NicolajHave/Selected-Frame-Floor-Planner/src/render/three/README.md

# `src/render/three/` — 3D adapter

3D view over the same `Project` slice the SVG canvas consumes
(`src/store/plannerStore.ts`). It introduces no domain fields of its own and
edits only through store actions, so undo, autosave and the parts list
behave the same in both views.

## Interaction

- Click an object to select it; drag to move it along the floor
  (`scene/useFloorDrag.ts`). Orbiting pauses during the drag, and the
  whole drag is one undo step (`beginGesture` / `endGesture`).
- Wall-mounted catalog items snap to the nearest wall while dragged
  (hold Alt to move freely), same as in 2D.
- With a placement tool armed, clicking the floor places the item.
- Room drawing stays in the 2D plan.

## Coordinate mapping

World coordinates are mm with y pointing "south" on the plan. The scene
is metres, Y-up:

- `(x, y) mm` → `(x·0.001, 0, y·0.001)` (see `MM` in `ThreeCanvas.tsx`)
- 2D rotation θ (clockwise on screen) → `rotation.y = -θ`
- Model origin: centre in X/Z, floor at Y = 0

## Mapping

| Domain | Three.js |
|---|---|
| `RoomPolygon.corners` | `Shape` → `ExtrudeGeometry` floor slab (`Floor.tsx`)  |
| Wall segments | `BoxGeometry(length, wallHeight, wallThickness)` |
| `Pillar.size` + position | `BoxGeometry(width, height, depth)` mesh |
| `InventoryItem.assetRef` | GLB via `assetCatalog.glbUrl` (`InventoryMeshes.tsx`) |
| No `assetRef` / loading | `BoxGeometry` in the item's stored size |
| Wall-hung items (logos) | Lifted to the catalog's `mountHeight` |
| Camera | `OrbitControls` (`controls/OrbitView.tsx`) |

## Assets

Catalog models under `public/assets/3d/*.glb` are generated by
`scripts/generate-assets.mjs` — parametric approximations built from the
SIS catalog dimensions. Regenerate with `node scripts/generate-assets.mjs`.
To upgrade any item to real CAD, export glTF/GLB from SolidWorks and
replace the file; the loader doesn't care where the GLB came from.
The three `.step` files alongside are the original CAD sources we have
so far (see `stepUrl` in `src/lib/assetCatalog.ts`).

## Files

```
three/
├── ThreeCanvas.tsx          # <Canvas/>, camera framing, MM constant
├── scene/
│   ├── Floor.tsx            # room polygon slab
│   ├── Walls.tsx            # box per wall segment
│   ├── Pillars.tsx
│   ├── InventoryMeshes.tsx  # GLB loader + placeholder boxes
│   ├── SelectionBox.tsx     # outline around the selected object
│   ├── useFloorDrag.ts      # select + drag along the floor plane
│   └── Lights.tsx
└── controls/
    └── OrbitView.tsx        # OrbitControls wrapper (no drei)
```
