NicolajHave/Selected-Frame-Floor-Planner/public/assets/thumbs/105-06-011-22-C.png

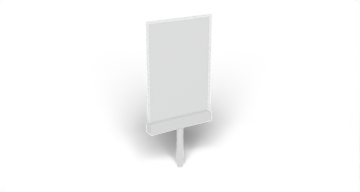
public/assets/thumbs/105-06-011-22-C.png
