NicolajHave/Selected-Frame-Floor-Planner/public/assets/thumbs/105-06-011.png

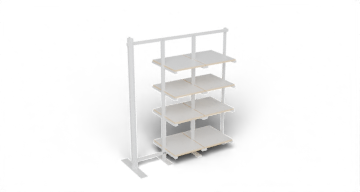
public/assets/thumbs/105-06-011.png
