NicolajHave/Selected-Frame-Floor-Planner/public/assets/thumbs/105-06-014.png

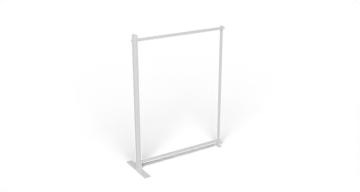
public/assets/thumbs/105-06-014.png
