NicolajHave/Selected-Frame-Floor-Planner/public/assets/thumbs/105-09-001.png

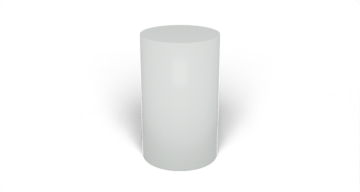
public/assets/thumbs/105-09-001.png
