NicolajHave/Selected-Frame-Floor-Planner/public/assets/thumbs/105-09-003.png

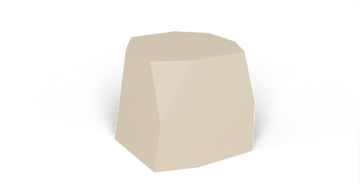
public/assets/thumbs/105-09-003.png
