NicolajHave/Selected-Frame-Floor-Planner/public/assets/thumbs/105-13-015.png

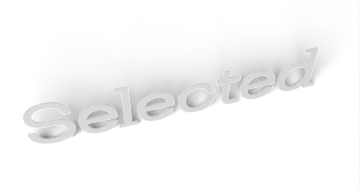
public/assets/thumbs/105-13-015.png
