NicolajHave/Selected-Frame-Floor-Planner/public/assets/thumbs/105-15-004.png

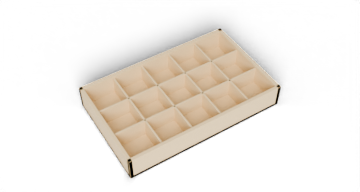
public/assets/thumbs/105-15-004.png
