NicolajHave/Selected-Frame-Floor-Planner/public/assets/thumbs/105-17-007.png

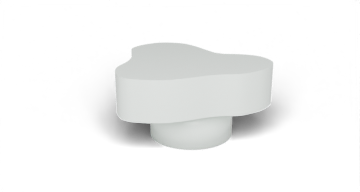
public/assets/thumbs/105-17-007.png
