NicolajHave/Selected-Frame-Floor-Planner/public/assets/thumbs/105-19-001.png

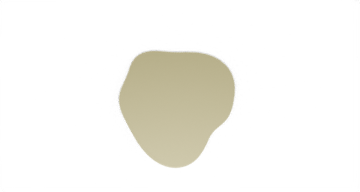
public/assets/thumbs/105-19-001.png
