NicolajHave/Selected-Frame-Floor-Planner/public/assets/thumbs/105-99-003.png

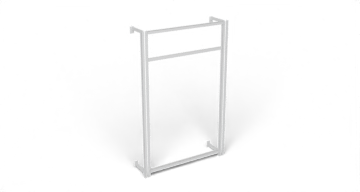
public/assets/thumbs/105-99-003.png
