NicolajHave/Selected-Frame-Floor-Planner/public/assets/thumbs/105-99-005.png

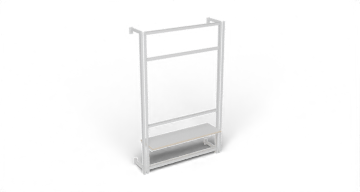
public/assets/thumbs/105-99-005.png
