NicolajHave/Selected-Frame-Floor-Planner/public/assets/thumbs/105-99-009.png

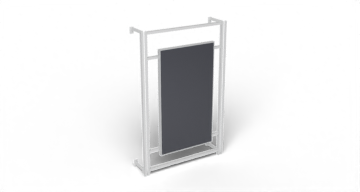
public/assets/thumbs/105-99-009.png
