NicolajHave/Selected-Frame-Floor-Planner/public/assets/thumbs/112-18-001.png

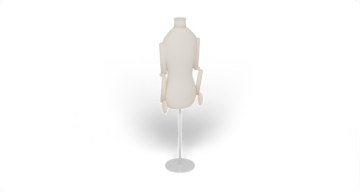
public/assets/thumbs/112-18-001.png
