NicolajHave/Selected-Frame-Floor-Planner/(commit log)

2026-05-08 Add STEP asset library so inventory can carry 3D refs
    Three STEP files (105-06-001-E, 105-09-002-A, 105-17-007-01-A) are
    shipped under public/assets/3d/ and surfaced through a new asset
    library sidebar. Picking an asset arms add-inventory mode and the next
    canvas click drops an InventoryItem with the catalog name, footprint
    and assetRef set. The 2D renderer keeps using size; the future
    Three.js adapter reads assetRef + stepUrl.
    https://claude.ai/code/session_01RRqgaDAz7FU3wsUYHZGQTx
2026-07-02 Add full SIS catalog with generated 3D models and working 3D view
    The asset library now carries all ~31 items from the Selected Frame SIS
    catalog (wall units, racks, podiums, tables, accessories, logos,
    mannequins, carpet) with the catalog's authoritative dimensions —
    including corrected sizes for the three items previously estimated from
    STEP bounding boxes.
    Every item gets a lightweight parametric GLB (about 7 kB average,
    0.26 MB total) generated by scripts/generate-assets.mjs from the
    catalog dimensions. The new 3D view (three + @react-three/fiber,
    dynamically imported) renders the room polygon as a floor slab, walls
    extruded to wallHeight, pillars, and inventory as its GLB model with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
2026-10-14 Close the six biggest usability gaps
    - Autosave: the project persists to localStorage (zustand persist,
    hydrated after mount and validated through migrate()), so a reload
    no longer loses the plan.
    - Undo/redo: every edit is recorded; drags in 2D and 3D are grouped
    into one step via beginGesture/endGesture. Cmd/Ctrl+Z, Shift+Cmd/
    Ctrl+Z, Ctrl+Y and toolbar buttons.
    - Rotation: drag handle on the selected object (15° snaps, Alt for
    free), R / Shift+R for ±90°. Rotations are normalised to [0, 360).
    - Wall snapping: wall units and logos snap flush to the nearest wall,
    back to the wall, when placed or dragged; Alt places freely. Logos
    hang at 2.1 m in 3D. Inventory now marks its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
2026-10-14 Import a floor plan as an underlay and set its scale
    The panel can import the store's plan as a PDF (first page, rendered
    with pdf.js on demand) or an image. It is stored in the project as a
    compressed JPEG, so saved files and autosave stay self-contained. After
    import the planner asks for two clicks on a known distance and its real
    length, then scales the plan around the first point. The underlay has
    opacity, Move/lock and Replace/Remove controls, and every change can be
    undone.
    Autosave now batches writes (at most one per 300 ms, flushed when the
    page is hidden), because a plan image makes the project ~1 MB and drags
    update it every frame. A failed write raises an sf-autosave event.
    Co-A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
2026-10-14 Set exact wall lengths, by typing them while drawing or in the room panel
    - While drawing, type a length (mm) and press Enter: the next corner is
    placed that far towards the cursor, snapped to 45° (Alt for any
    angle). The preview line shows the typed wall before it is placed.
    - Selecting the room numbers its walls on the plan, and the panel lists
    every wall's length as an editable field. Hovering a field highlights
    that wall. Changing a length keeps the room's shape: the far corners
    move along the wall up to the next parallel wall, which absorbs the
    difference, so rectangles stay rectangular and L-shapes keep their
    legs (geometry/walls.ts, unit-tested).
    - The footer now says w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
2026-10-14 Add doors, double doors, passages and windows
    A new "Doors & windows" section at the top of the library places an
    opening on the wall nearest the click (in 2D or 3D). Openings are
    anchored to their wall's start corner plus a distance along it, so they
    stay put when walls are resized and are carried over when a corner is
    inserted into or removed from their wall.
    - 2D: the wall is cut out, with jambs, a door leaf and swing arc,
    double leaves, a dashed passage or a glazed window. Drag an opening
    along its wall or onto another one, as a single undo step.
    - Panel: type, width, height, sill (windows), distance from the wall's
    start, hinge side and swing direction. R flips the hinge and Shif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
2026-10-14 Update README and architecture notes for the current feature set
    The README described the original 2D MVP. It now walks through the
    real workflow (import plan, trace with exact lengths, doors and
    windows, fixtures, 3D, parts list), lists the shortcuts and test
    commands, and documents the file formats. ARCHITECTURE.md gains the
    Opening and PlanUnderlay types, the new tools and a testing section.
    Claude-Session: https://claude.ai/code/session_01RRqgaDAz7FU3wsUYHZGQTx
2026-10-15 Check the layout and show distances around the selected object
    Layout check (lib/layout.ts, unit-tested):
    - Overlapping floor objects (separating-axis test, so rotated items
    count correctly).
    - Objects that stick into a wall or out of the room, measured against
    the walls' inner faces.
    - Doors and passages with something in front of them: the swing of an
    in-opening door, or 900 mm to approach a passage / out-swinging door.
    - Aisles narrower than the project's minimum (900 mm by default, set in
    the panel) between objects, or between an object and the wall. Gaps
    under 100 mm count as pushed together, not as an aisle.
    Trays, signs, carpets and wall-hung logos are not floor obstacles.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
2026-10-15 Export the plan as an A3 PDF drawing
    A new PDF button in the top bar produces an A3 landscape document
    (jsPDF, loaded on demand):
    - Page 1: the plan drawn to the largest standard scale that fits
    (1:20 … 1:1000), with solid walls cut at their openings, door leaves
    and swing arcs, passages and windows, opening widths, every wall's
    length on a dimension line, and each fixture outlined with its back
    edge and a number. A right-hand column lists the numbered fixtures
    and holds the title block (project, date, scale, floor area, wall
    length and height, units, weight, hanger capacity). A scale bar sits
    under the drawing. A calibrated underlay is drawn faintly beneath,
    clipped to th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
2026-10-15 Electrical points and plan notes, with an electrical plan in the PDF
    - Library "Electrical & notes": socket, double socket, network, LED logo
    power, screen, switch (on a wall, at a height, with a note for the
    electrician) and floor box (anywhere on the floor); drag along walls,
    kept between the corners' inside faces, re-anchored when corners change
    - Notes on the plan: text box, optional arrow with a draggable tip
    - 3D: outlet plates on the walls, floor boxes in the floor
    - PDF: Electrical Plan page (E1, E2… numbered along the walls, legend with
    type, wall, height and note), outlets drawn into the elevations at their
    height and on the height ladder, notes on the plan view
    - Tests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
2026-10-30 Blender pipeline for catalog models; pilot: Wall Unit 1400 – Shelves
    - scripts/blender: helpers (40×40×4 angles, boxes, bolts, materials tuned
    for the planner's lighting, GLB export with the planner's axes) and a
    build script (GLB, optional .blend and Cycles preview)
    - 105-99-004 rebuilt from the catalog render and the &elements parts list:
    double-angle columns, top and bottom rails, brackets and wall plates,
    four shelves (MDF with oak edge and steel laminate) on front and back
    angles, feet and bolt heads
    - generate-assets.mjs leaves Blender-built models alone
    Claude-Session: https://claude.ai/code/session_01RRqgaDAz7FU3w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
2026-10-30 Real floor rack and podium models from the STEP files; prices from the &elements quote
    - STEP → OBJ with OpenCascade (step-to-obj.mjs), imported into Blender
    (step_models.py): bolts and felt pads dropped, flat faces merged, rounded
    edges smoothed; ~525 kB per rack
    - Floor Rack 1400 is the STEP itself; 700, 1400 H1700 and 700 H1700 are
    derived from it (rails 510 mm shorter, posts 200 mm longer); the Short
    Oak Podium is the tall one at 400 mm
    - Catalog heights corrected to the STEP: racks 1508 / 1708 mm (the old
    1758 included the A5 sign, which is a separate item); generated jeans
    racks follow
    - Prices: the &elements quote (rev. 03, 16.02.2026) is the primary source;
    wall units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
2026-10-30 All wall units and the jeans racks in Blender
    - wall_units.py: the shared frame (double-angle columns, rails, brackets,
    wall plates) with building blocks for shelves, hanging rails, cross
    beams, the mirror box, the jeans unit and the screen
    - All ten wall units (1400 and 700) built from it, matched to the catalog
    renders; the pilot moves onto the shared code unchanged
    - Jeans racks single / double / triple: the STEP floor rack frame with
    extra posts and oak shelf sections running front to back
    - Mirror reads as a light, cool grey without reflections
    - Columns run the full 2288 mm
    Claude-Session: https://claude.ai/code/session_0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
2026-11-04 Volume table and Iconic table in Blender
    - Iconic table: the supplier's STEP top (1265 × 1200 × 340 mm, the only
    part in 105-17-007-01-A.step) lifted onto a cylindrical foot to 650 mm,
    centred under the top's mass, in mint lacquered MDF (NCS S 2010-G20Y)
    - Volume table: modelled from the catalog render and the &elements quote:
    recessed steel plinth, drawer cabinet with two drawers on each long side
    and grip grooves, open display level on three uprights; MDF panels with
    brushed steel laminate and oak edges
    - step_models: STEP files that are already Z-up can be imported as such
    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
2026-11-04 Blender models for the rest of the catalog: podium, logos, signs, trays, rack, mannequins, carpet
    - Iconic Podium: mint lacquered cylinder, Ø 450 × 750
    - Logos: "Selected" lettering scaled to 1200 × 225 mm; Corona steel
    letters with a warm halo behind, flat brushed steel (3 mm), and white
    lit LED letters (emissive in the GLB)
    - Signs: A5 table sign (acrylic, magnets, steel foot), floor price sign
    (sloped 2 mm steel), acrylic floor rack sign on its pin
    - Leather tray, oak trays 3×3 and 3×5 with dividers, slotted accessories
    rack on T-feet
    - Mannequins: lofted long-torso dress forms with birch arms on a pole and
    base
    - Carpet: organic shape, 2424 × 2809 × 25
    - Planner lighting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
2026-11-04 Logo depths: LED 25 mm, steel 6 mm
    - LED logo: 25 mm deep lit letters (catalog depth 25)
    - Stainless steel logo: 6 mm flat on the wall (catalog depth 6)
    - Corona light logo: 6 mm steel letters on spacers, 20 mm off the wall in
    all, with the halo behind
    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
2026-11-06 Real Selected wordmark in the logos; library shows the 3D models
    - Logos: the wordmark from the brand's vector file (MAIN_LOGO.ai, kept
    as scripts/blender/assets/selected-wordmark.svg) replaces the stand-in
    font; LED 25 mm, steel 6 mm, Corona 6 mm letters 20 mm off the wall.
    - Library cards show a picture of each model, rendered in Blender
    (build.py --thumbs → public/assets/thumbs), instead of a grey box.
    - The library panel no longer overflows its 240 px column (fieldset
    min-width), which clipped the cards.
    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
2026-11-06 2D plan shows each fixture as its model from above; carpet from its drawing
    - Carpet Size 1 is built from the production drawing (10519002 Rev 01,
    four splines; kept as scripts/blender/assets/carpet-size-1.dxf/.json),
    fitted to the catalog's 2424 × 2809.
    - build.py --plan projects every Blender model onto the floor: the filled
    silhouette plus the outlines of its parts (src/lib/planShapes.json,
    38 kB for all 35 items).
    - The plan and the PDF's plan view draw those shapes (rotated, and unit
    by unit for wall racks) instead of plain rectangles; the footprint stays
    as a faint dashed outline and the hit area.
    Claude-Session: htt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
2026-11-07 Lock the floor layout, and lock single fixtures in place
    - "Lock layout" in the top bar: walls, corners, doors, windows and pillars
    can't be dragged, resized, added or deleted (2D, 3D, keyboard, panels);
    fixtures, notes and electrical points still move. Their panels show
    read-only with an Unlock link; drawing tools and door/window cards are
    disabled. Saved with the plan.
    - Fixtures can be locked one by one (panel button or L) or together from
    the group panel; a locked fixture can't be moved, turned, resized or
    deleted and shows a padlock on the plan. Group moves, align, distribute
    and rotate leave locked members where they are. Copies come unlocked.
    - Locks are enforced in the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
2026-11-07 Wall units after the &elements technical drawings: one frame for all depths, sidehang bar between the uprights
    From 105-99-005-C, -007-B, -009-A and -010-A (side views measured at 1:20):
    - Every unit has the same frame: each side a pair of 40 mm uprights (95 mm
    over both, so 620 mm clear on a 700 unit, 1316 on a 1400) standing
    345–388 mm from the wall on 391 mm arms. Until now the uprights stood at
    the front of each unit's catalog depth, so deeper units sat further off
    the wall and a mixed rack did not line up.
    - Only the contents reach further forward, to each unit's catalog depth:
    shelves 117–517 mm from the wall (through the frame's plane), the mirror
    box to 434, the scree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
2026-11-08 Rectangle tool for rooms; note text saved as you type
    - "Rectangle" in the toolbar: drag out a room, with its width and depth
    shown while dragging (grid snap applies). It becomes an ordinary closed
    room of four walls, selected, so corners can be dragged and exact
    lengths typed as before. Replaces the current walls; blocked while the
    layout is locked; a click without a drag does nothing.
    - Notes: the text was only saved when the field lost focus, so it could be
    lost (or land in the wrong note) when clicking straight onto another
    note or the plan. It is now saved as you type and shows on the plan at
    once; the typing is one undo step; Enter still makes a new line; each
    note gets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
2026-11-08 Move the view with a right-drag from anywhere on the plan
    Right- or middle-button drag, or Space + left drag, pans the 2D plan
    wherever it starts: over the room, a wall, the plan underlay or a
    fixture, not only on empty floor outside the room. Nothing under the
    pointer is selected or moved, and the browser menu doesn't open on the
    plan. Listed under Shortcuts.
    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
2026-11-08 Budget target and capacity (hangers, shelf metres) in the parts list
    - Budget: set what the fixtures may cost; the parts list shows the total
    against it with a bar, what's left or how much over, and the share
    used. Saved with the plan; hidden with the prices in shared views.
    - Capacity: hangers and shelf metres for the whole shop, and per m² of
    floor. Shelf metres per catalog item (shelves × their width between the
    uprights: 1400 shelves 5.22 m, 700 shelf 2.48 m, 1400 sidehang + shelf
    1.31 m, category library 3.55 m, single / double / triple shelf floor
    racks 1.68 / 3.28 / 4.8 m). Also on the PDF's summary.
    Claude-Session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
2026-11-08 Keep the 'Hanger capacity' label in the capacity block
    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
2026-11-08 Version history: up to three earlier versions per cloud plan
    - Database (fp_ objects only): fp_project_versions with three fixed
    slots per plan, overwritten in turn, so nothing is deleted except
    with the plan. fp_save_project now keeps the plan as it was when a
    save comes 30+ minutes after the previous one (a new working
    session); automatic versions only replace automatic ones, so versions
    kept on purpose are never pushed out by them. New functions
    fp_list_versions, fp_get_version, fp_save_version.
    - Top bar: Versions dialog to keep a version (optional label), see who
    kept which and when, and restore one (one undo step, synced like any
    edit).
    - Fake cloud mirrors the slot rul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
2026-11-08 Cloud drive for drawings: database migration (not yet applied)
    Private Storage bucket fp-drawings (50 MB per file) with policies for
    that bucket only, the fp_drawings table and fp_list_drawings /
    fp_add_drawing / fp_delete_drawing. Waiting for confirmation before it
    is applied to the shared database; the app side follows.
    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
2026-11-08 Cloud drive for store drawings
    - Shared drive (Supabase Storage bucket fp-drawings, policies for that
    bucket only, fp_drawings for names, shops and uploaders): every
    confirmed @bestseller.com planner can upload a PDF, DWG, DXF or image
    (up to 50 MB), search the drive and use a drawing as the plan; only
    the uploader can delete it.
    - Plan underlay: "From cloud drive…" / "Replace from cloud drive…"
    opens the drive; Use as plan goes through the same page/crop and CAD
    dialogs as a file from disk. Files are uploaded as raw bytes, so the
    stored file is exactly the original.
    - Fake cloud gains the storage endpoints and drive functions; e2e tests
    for upload/import/delete, colleagu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
2026-11-08 3D walk-through at eye level, and snapshots
    - Walk through (3D view): stand in the shop at 1.65 m, just inside the
    door (or in the middle, looking along the room). Drag to look around,
    W A S D / arrow keys to walk, Shift to go faster, the wheel steps.
    Walls and fixtures can't be walked through: a step into one slides
    along it. Fixtures aren't selectable while walking.
    - A small map shows where you are and which way you look; click it to
    jump. Entrance takes you back to the start, Overview (or Esc) back to
    the orbit view, with the overview camera restored.
    - Snapshot saves the current view (overview or walk) as a PNG.
    - Unit tests for the start pose and collision; e2e for walking,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
2026-11-08 Layout variants (A, B, …) with a side-by-side comparison
    - Several fixture layouts per plan in the same room: + Layout variant
    adds a copy of the current layout or an empty one; tabs above the
    plan switch between them (2D and 3D). Room, walls, openings, pillars,
    electrical points, notes and the underlay are shared; each layout has
    its own fixtures and accessories. The active layout's fixtures stay in
    project.inventory, so the rest of the planner works unchanged.
    - The active tab's menu renames, duplicates or deletes a layout (one
    undo step each); up to six layouts.
    - Compare: fixtures, price and €/m², hanger capacity and per m², shelf
    metres, layout problems and the budge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
2026-11-08 Comments on cloud plans and view-only links
    - Database (fp_ objects only, already applied): fp_project_comments and
    functions for colleagues (fp_list_comments / fp_add_comment, any role)
    and for view-only link holders, who give a name
    (fp_list_shared_comments / fp_add_shared_comment, open to anon via an
    unrevoked link); owners and editors resolve and reopen
    (fp_set_comment_resolved). Limits: 2000 characters, 1000 comments a
    plan, 20 a minute through links. Nothing is deleted except with the
    plan.
    - Comments button (top right of the plan) with the count of open
    comments; a panel to read, write, pin to a spot on the plan (and the
    layout on screen), show on the plan, resolve a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
2026-11-09 Right-click menu on the plan
    - A right-click without dragging opens a menu for what is under the
    pointer (a right-drag still pans): a fixture or the selected group
    (duplicate, copy, rotate either way, lock/unlock, delete), a pillar or
    note, a door or window (properties, delete), a wall (add a door,
    double door, window or opening exactly there, add a corner, wall
    properties) or the floor (paste here, add a note or pillar, measure
    from here, select all). Layout-locked actions are greyed out with the
    reason; view-only plans only offer Copy.
    - With a tool in hand (placing, measuring, …), a right-click puts it down.
    - The menu stays on screen and closes on Esc, a click elsewhere o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
2026-11-09 Automatic proposal: mannequins on the carpet, logo over the leftmost unit, racks in pairs
    - Two mannequins stand beside the Iconic Table on the carpet, right by
    it (touching distance, so the layout check sees them together), in
    either style.
    - The brand logo hangs centred over the leftmost wall unit (seen from
    inside the shop) on the wall facing the entrance.
    - Volume shops pair their floor racks end to end, touching, with the
    aisle around the pair; brand shops keep them single. The rack limit
    counts each rack.
    - Unit tests for each rule; the aisle test accepts fixtures that stand
    together (≤ 100 mm) as well as the full aisle.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
2026-11-09 Automatic proposal: a logo in every proposal — LED from 30 m², stainless steel below
    - Both styles get a logo whenever there is a solid wall tall enough for
    it: the LED logo from 30 m², the Stainless Steel Logo below.
    - It goes on the wall the entrance looks at, centred over that wall's
    leftmost wall unit; with no units there (or wall racks switched off),
    centred on the wall's longest stretch clear of doors and windows.
    Glass walls and walls too low for it are passed over.
    - Dialog and README say so; unit tests for both sizes, both styles,
    without wall racks and with only glass walls.
    Claude-Session: https://claude.ai/cod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
